MaslowCommunityGarden/The-Meticulous-Z-Axis/mainpicture.JPG

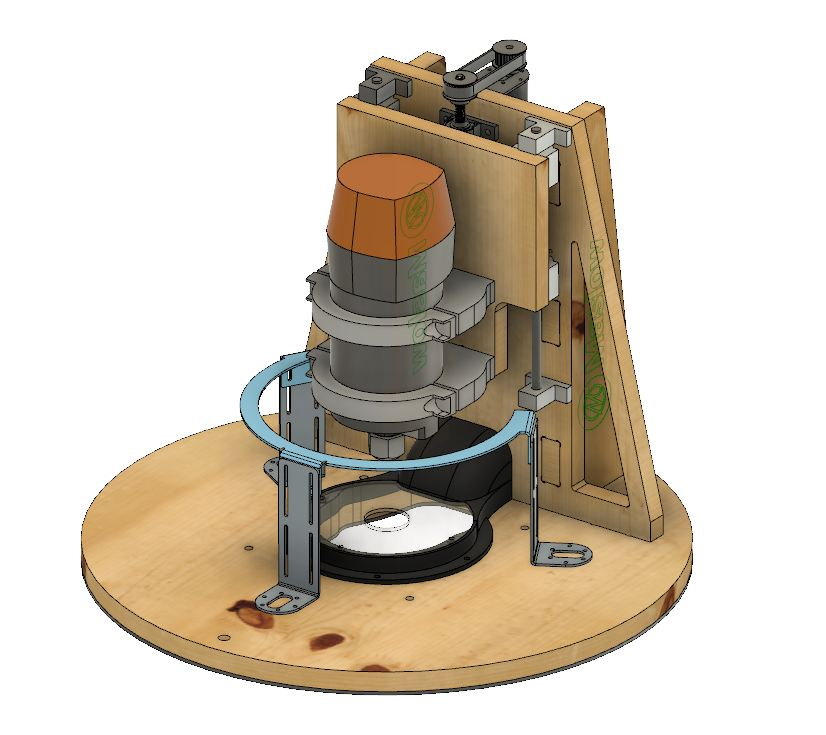
mainpicture.JPG
