MaslowCommunityGarden/The-Meticulous-Z-Axis/README.md

# The Meticulous Z-Axis

An improved Z-Axis sled that uses the Rigid R2200 as the spindle
