MaslowCommunityGarden/The-Meticulous-Z-Axis/2D CAD Files/MeticulousSled-Gussets.pdf

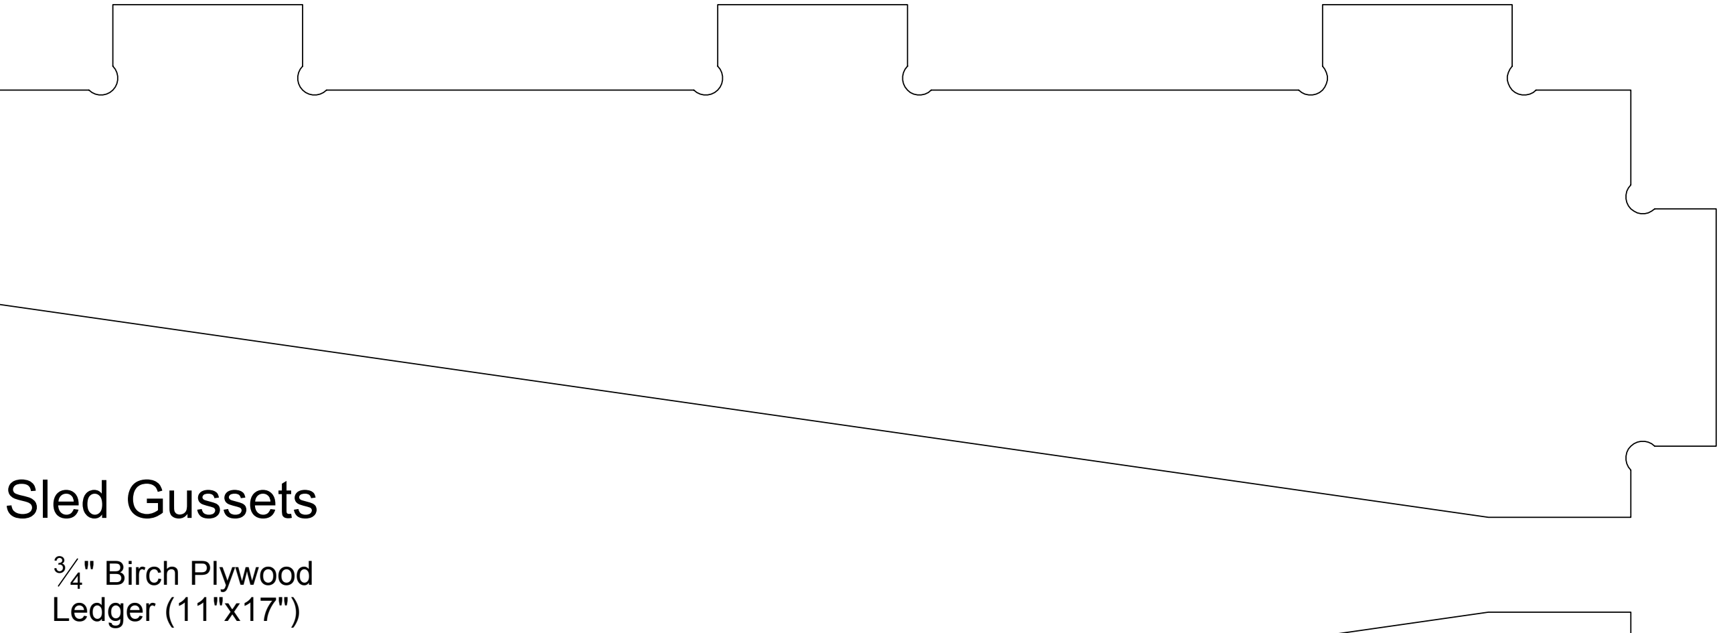
[picture p2: figure]
4" Birch Plywood Ledger (11"x17"); Sled Gussets
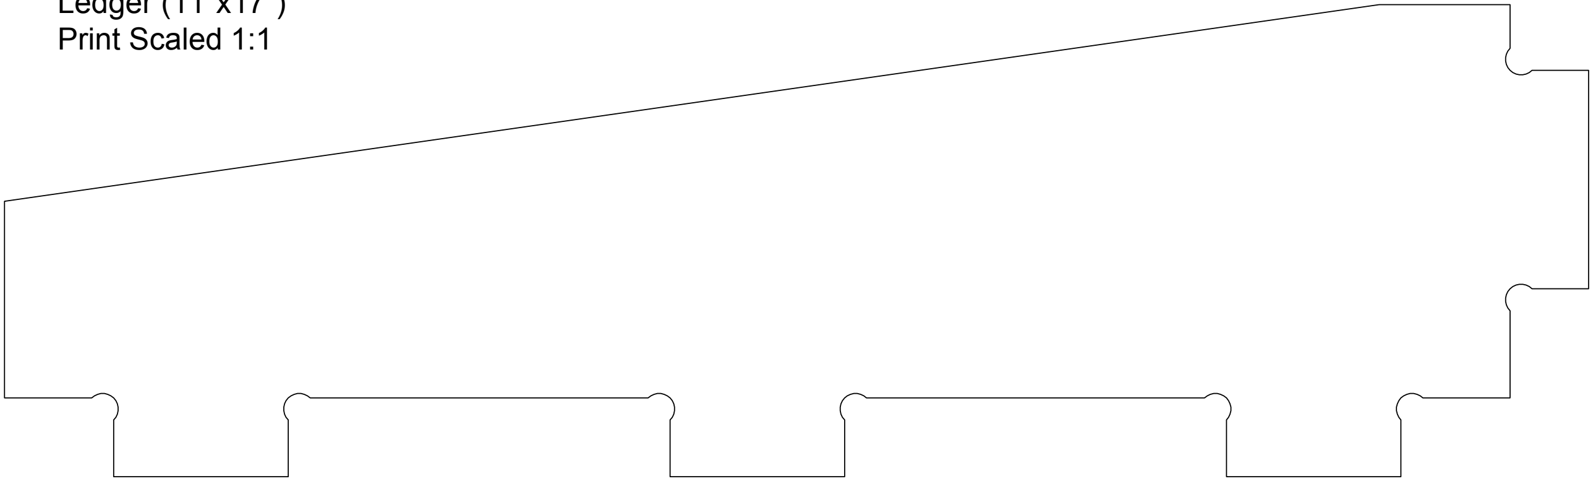
[picture p3: figure]
Print Scaled 1:1
