MaslowCommunityGarden/The-Meticulous-Z-Axis/2D CAD Files/MeticulousSled-PlywoodChuteWindow.pdf

1
8" Clear Acrylic
Letter (8.5" x 11")
Print Scaled 1:1

## Ply Chute Windows

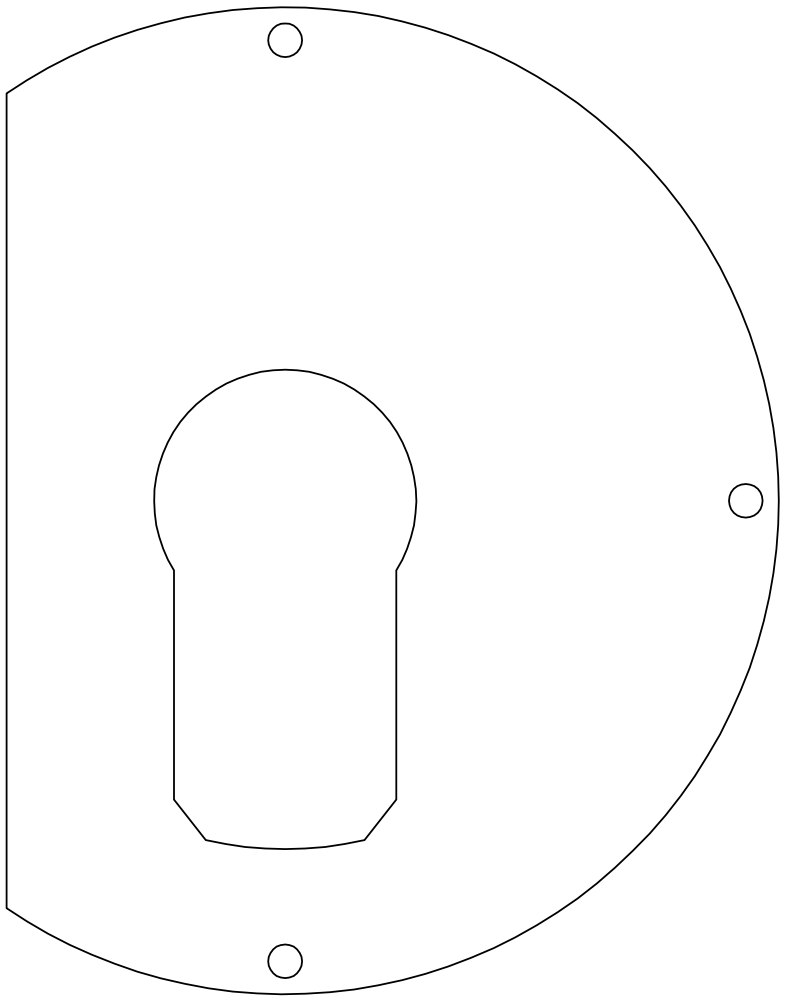
[picture p4: figure]
