MaslowCommunityGarden/The-Meticulous-Z-Axis/2D CAD Files/MeticulousSled-SpindleClamps.pdf

## Spindle Clamps

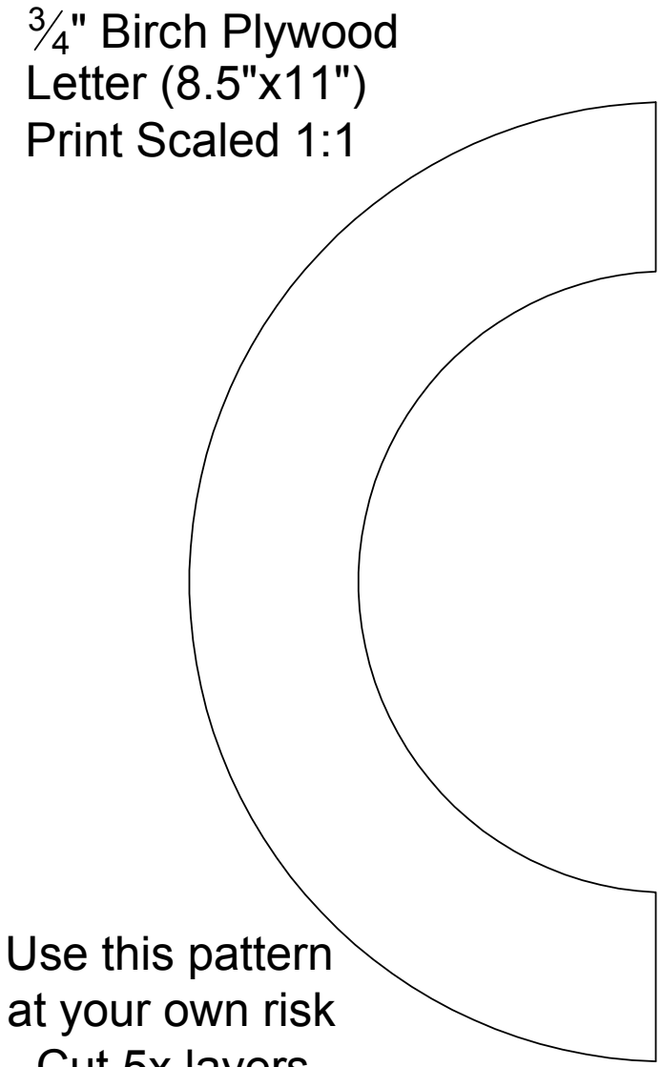
[picture p5: figure]
3 4" Birch Plywood Letter (8.5"x11") Print Scaled 1:1; Use this pattern at your own risk
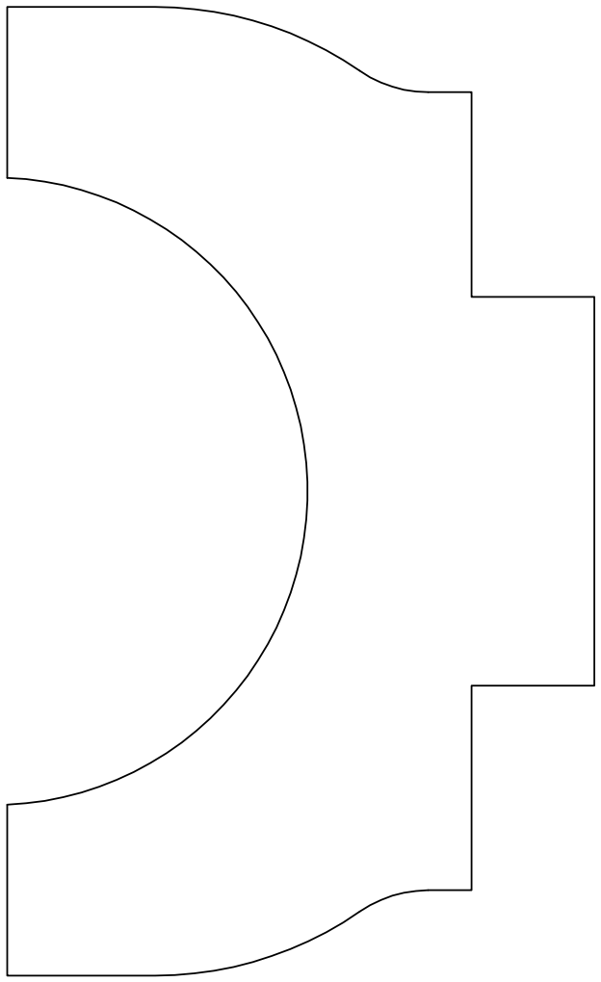
[picture p6: figure]
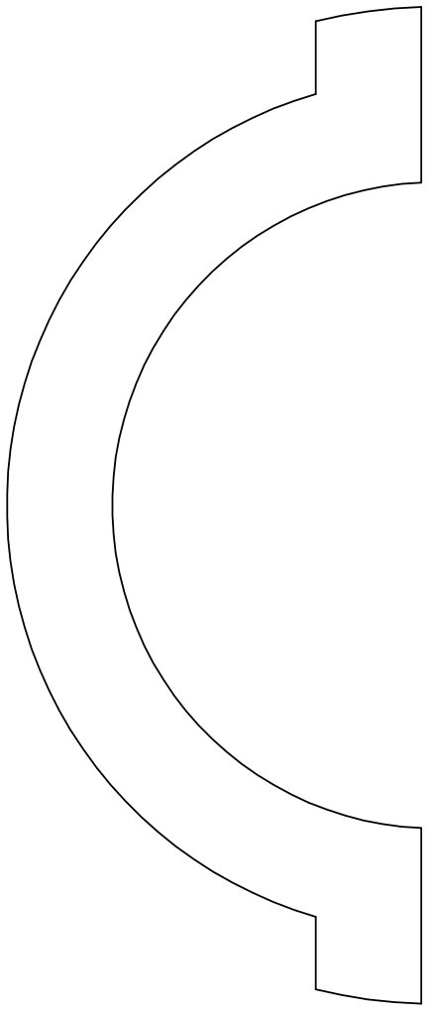
[picture p7: figure]

- Cut 5x layers
- Glue all layers
together
