MaslowCommunityGarden/The-Meticulous-Z-Axis/BOM.md

Z-Axis - $67.92 before shipping

* [300mm Linear rail and lead screw kit](https://www.amazon.com/Mergorun-Horizontal-Bearings-coordinate-equipment/dp/B06XP7HPLQ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) - Amazon - $35.99

* [XL 10 tooth Timing Pulley for lead screw](https://www.amazon.com/uxcell-Aluminum-Timing-Pulley-Flange/dp/B0747G2D4S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) - Amazon - $6.69

* [XL 30 tooth Timing Pulley for servo motor](https://www.amazon.com/dp/B00JR6MIJO/ref=twister_B07T5SDJJQ?_encoding=UTF8&th=1) - Amazon $9.75

* [XL 1/4" x 9" timing belt](https://www.amazon.com/gp/product/B00CMI70T2/ref=crt_ewc_title_huc_2?ie=UTF8&psc=1&smid=ATVPDKIKX0DER) - Amazon - $11.99

* [12x 10-32 Threaded inserts for softwood](https://www.amazon.com/Z-Threaded-Hex-Flush-Internal-Threads/dp/B002WC8TSY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) - Amazon - $3.50

* An assortment of #8 wood screws

* 2x 1/4-20 x 1 1/2" hex cap screws, with nylock nut and washers

* 12x 10-32 x 3/4" Pan Head Machine Screws

* [16x M4 x 0.7 x 30mm Pan Head Machine Screws](https://www.homedepot.com/p/Everbilt-M4-0-7-x-30-mm-Phillips-Pan-Head-Zinc-Plated-Machine-Screw-2-Pack-802908/204282670) - linked pack is 2x per pack, order 8x for needed quantity. 

Spindle Clamps:

* [8x 3/8"-16 Heat set threaded inserts](https://www.mcmaster.com/93365A310/)

* [4x 3/8"-16 x 3/4" Socket Cap screws](https://www.mcmaster.com/91251A622/)

* [4x 3/8"-16 x 3/4" Flat Head screws](https://www.mcmaster.com/90273A439/)

Dust Hood:

* [3x 10-32 Heat-set Insert](https://www.amazon.com/initeq-Threaded-Inserts-Printing-Plastic/dp/B07B9P9R3B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) - Amazon - $8.49

* 3x 10-32 x 5/16" Flat head Machine screws

* Some form of plastic glue or epoxy to help glue the chute and body of the hood together.
