MaslowCommunityGarden/The-Meticulous-Z-Axis/2D CAD Files/MeticulousSled-Plywood_Nested.dxf

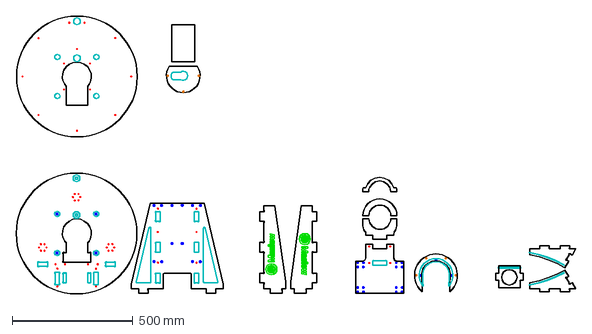
[picture p8: CAD file, 2019-10-13]
2D CAD Files/MeticulousSled-Plywood_Nested.dxf
2317.8 x 1150.1 mm
