MaslowCommunityGarden/The-Meticulous-Z-Axis/STL Files/Spindle Bracket Top Back.stl

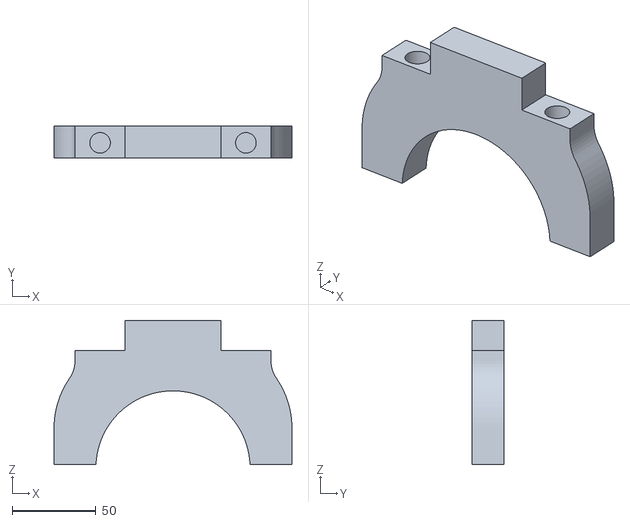
[picture p9: CAD file, 2020-06-02]
STL Files/Spindle Bracket Top Back.stl
142.0 x 19.0 x 86.0
