MaslowCommunityGarden/The-Meticulous-Z-Axis/2D CAD Files/MeticulousSled_Nested.dxf

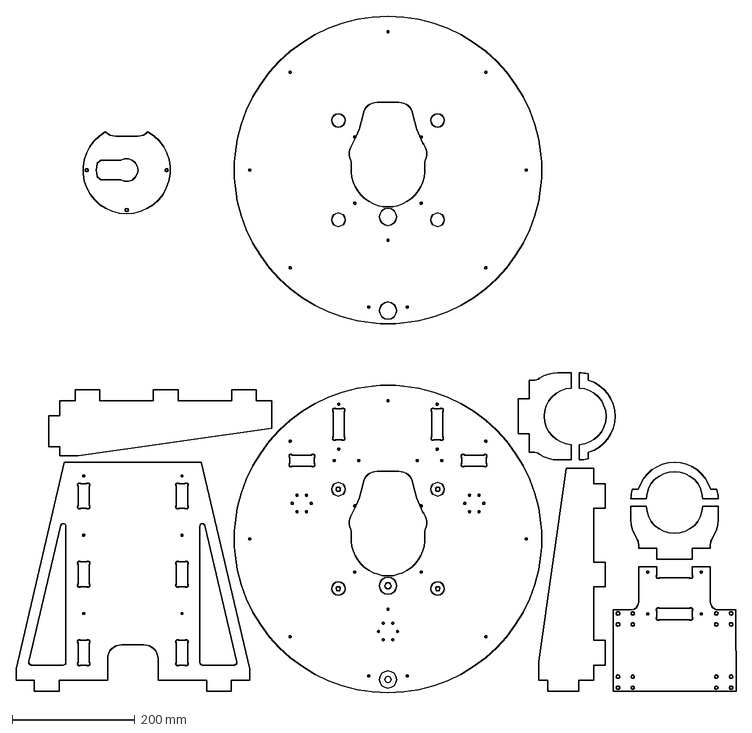
[picture p10: CAD file, 2019-08-20]
2D CAD Files/MeticulousSled_Nested.dxf
1171.0 x 1100.0 mm
