MaslowCommunityGarden/The-Meticulous-Z-Axis/STL Files/Spindle Bracket Top Front.stl

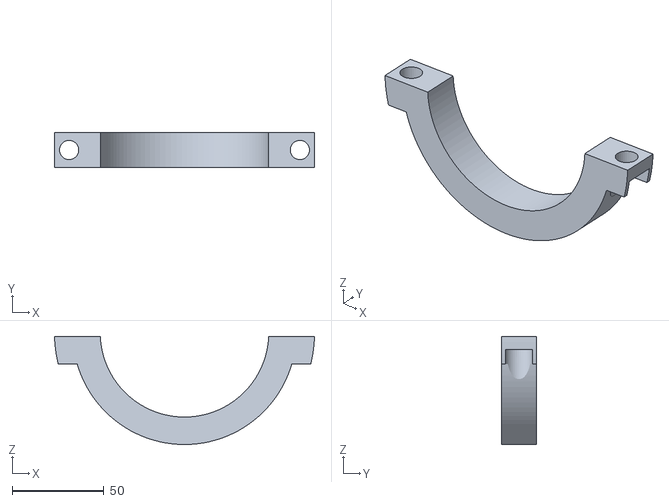
[picture p11: CAD file, 2020-06-02]
STL Files/Spindle Bracket Top Front.stl
141.9 x 19.0 x 59.0
