MaslowCommunityGarden/The-Meticulous-Z-Axis/STL Files/Dust Hood Chute V2.stl

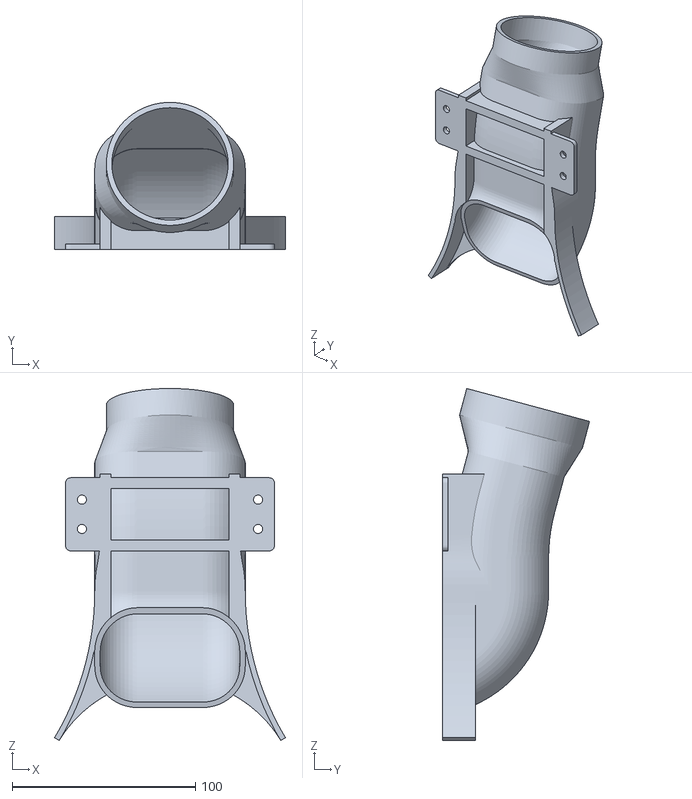
[picture p12: CAD file, 2018-07-31]
STL Files/Dust Hood Chute V2.stl
126.1 x 80.4 x 192.2
