MaslowCommunityGarden/The-Meticulous-Z-Axis/STL Files/Dust Hood Body V2.stl

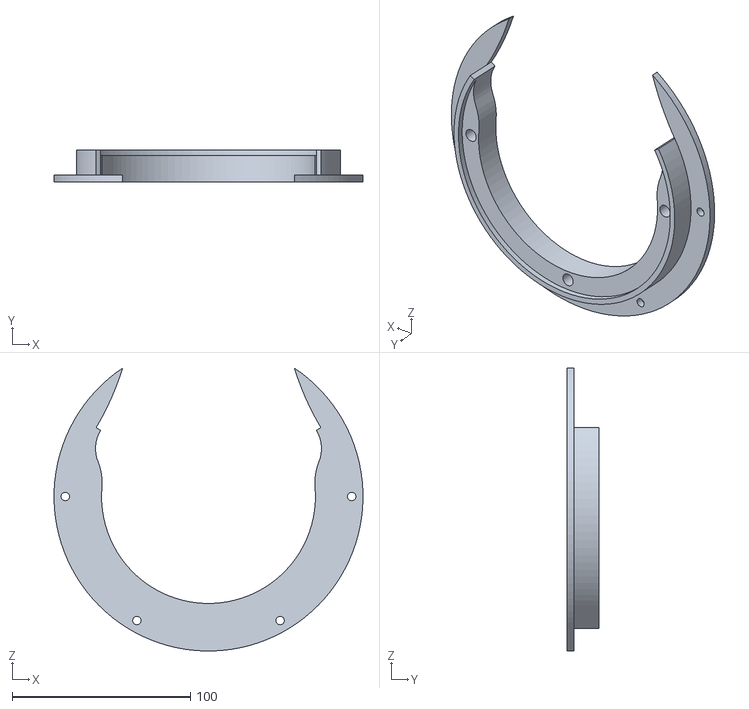
[picture p13: CAD file, 2018-07-31]
STL Files/Dust Hood Body V2.stl
173.4 x 18.0 x 158.8
