MaslowCommunityGarden/The-Meticulous-Z-Axis/STL Files/Z_Axis_Lead_Screw_Nut_Bracket.stl

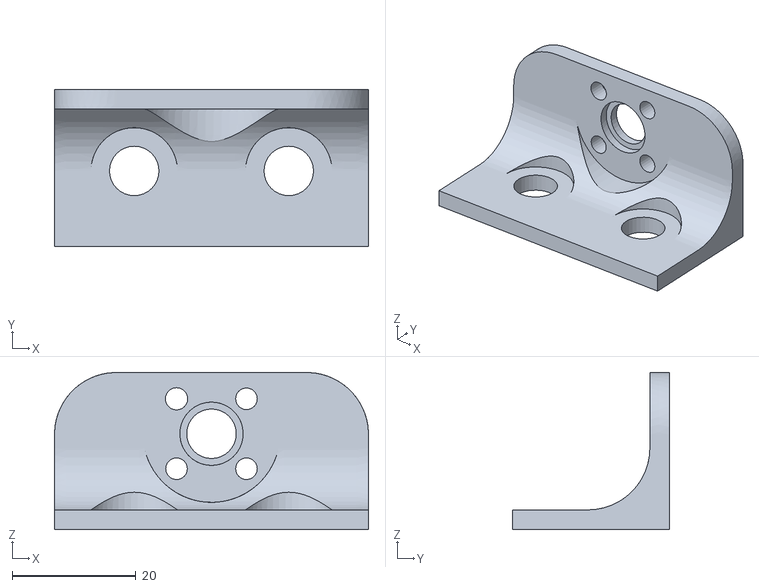
[picture p14: CAD file, 2020-06-02]
STL Files/Z_Axis_Lead_Screw_Nut_Bracket.stl
50.8 x 25.4 x 25.4
