MaslowCommunityGarden/The-Meticulous-Z-Axis/(list of files, cad)

Other CAD files:
2D CAD Files/MeticulousSled-Drawings.dwg
