MaslowCommunityGarden/The-Meticulous-Z-Axis/2D CAD Files/MeticulousSled-PrintedChutePad.pdf

## Printed Sled Pad

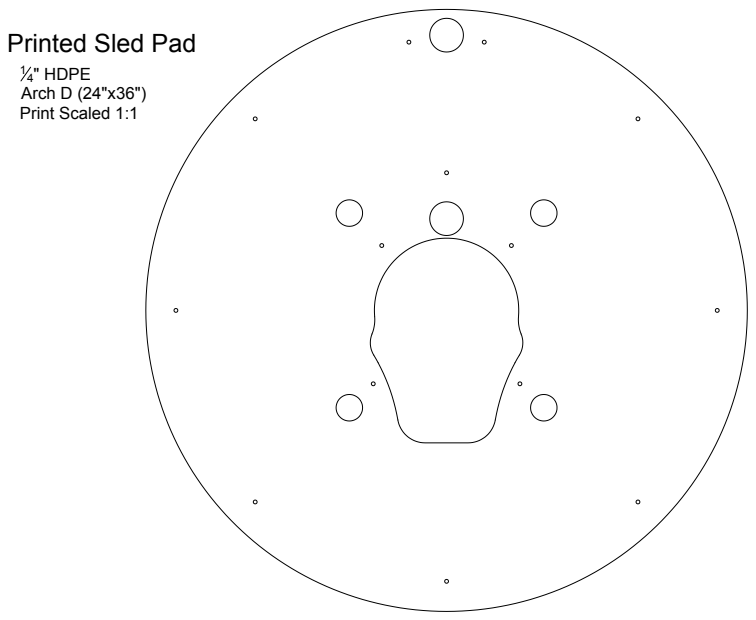
[picture p15: page 1]
4" HDPE Arch D (24"x36") Print Scaled 1:1
