MaslowCommunityGarden/The-Meticulous-Z-Axis/2D CAD Files/MeticulousSled-PrintedChuteTemplate.pdf

## Printed Sled Templates

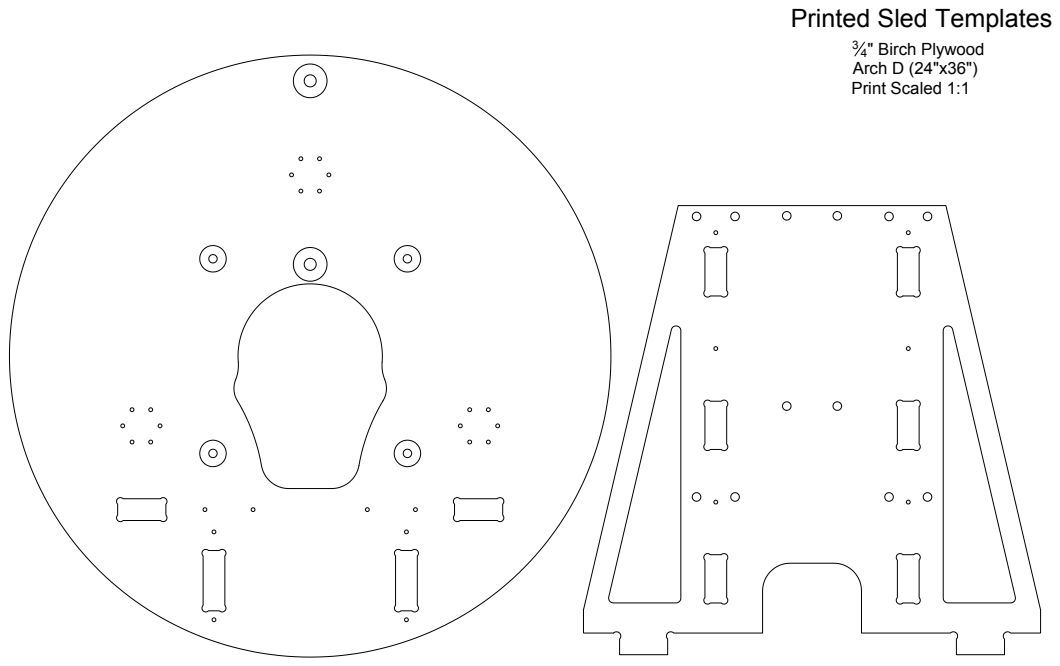
[picture p16: page 1]
4" Birch Plywood Arch D (24"x36") Print Scaled 1:1
