MaslowCommunityGarden/The-Meticulous-Z-Axis/2D CAD Files/MeticulousSled-Carriage.pdf

## Carriage Plate

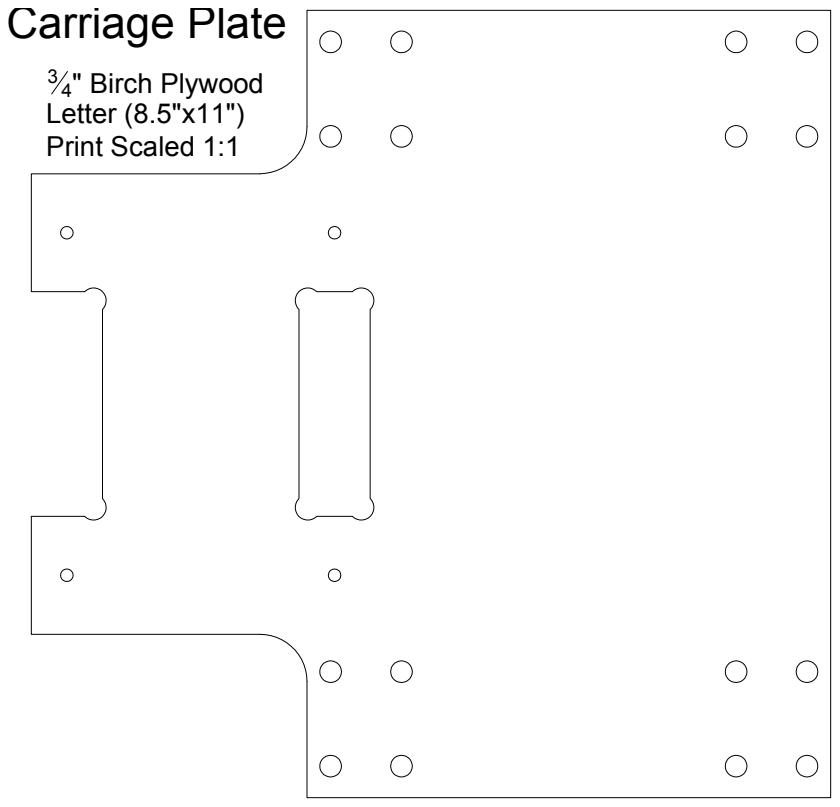
[picture p17: page 1]
4" Birch Plywood Letter (8.5"x11") Print Scaled 1:1
