MaslowCommunityGarden/The-Meticulous-Z-Axis/2D CAD Files/MeticulousSled-PlywoodChute.pdf

# Ply Chute

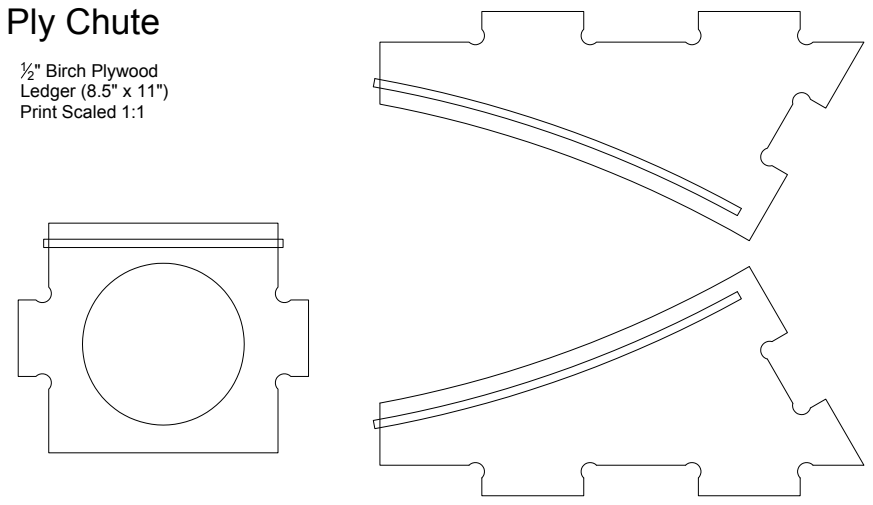
[picture p18: page 1]
2" Birch Plywood Ledger (8.5" x 11") Print Scaled 1:1
