MaslowCommunityGarden/The-Meticulous-Z-Axis/2D CAD Files/MeticulousSled-PlywoodChuteHorseshoe.pdf

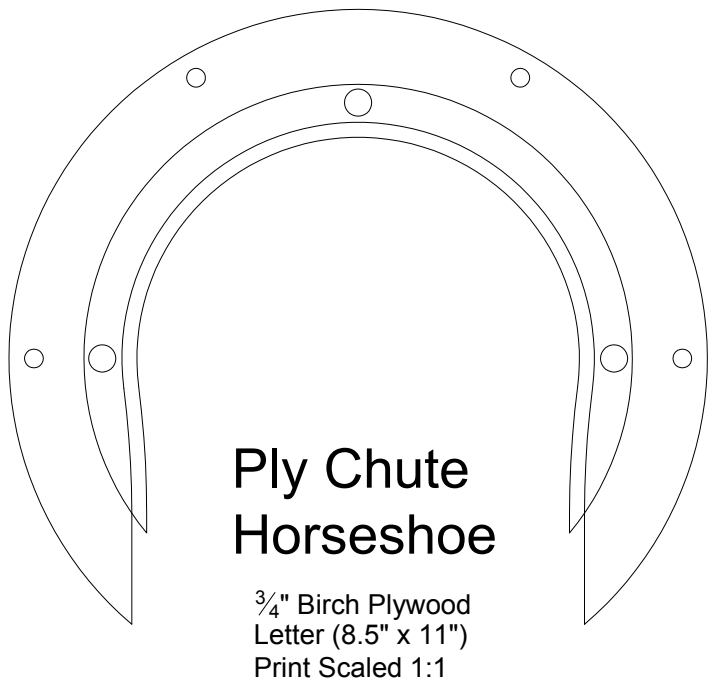
[picture p19: page 1]
3 4" Birch Plywood Letter (8.5" x 11") Print Scaled 1:1; Ply Chute Horseshoe
