MaslowCommunityGarden/The-Meticulous-Z-Axis/2D CAD Files/MeticulousSled-PlywoodChutePad.pdf

## Plywood Sled Pad

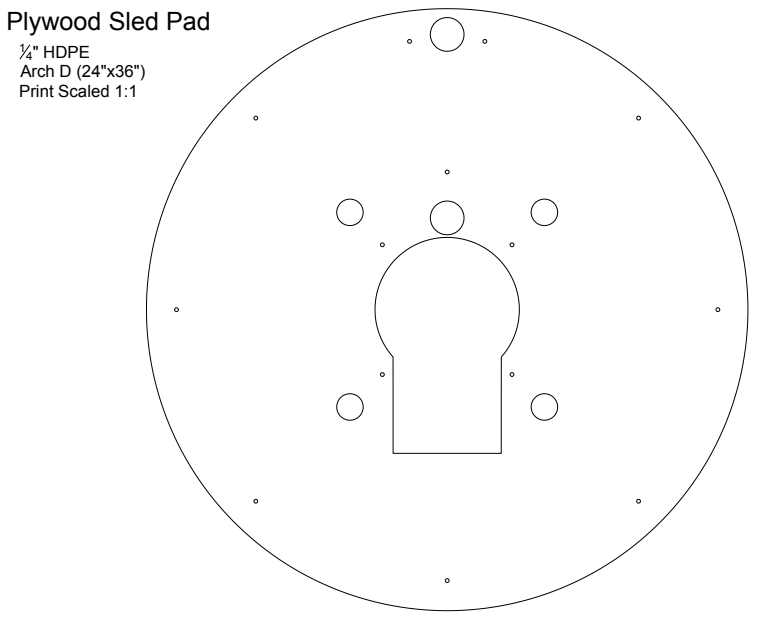
[picture p20: page 1]
4" HDPE Arch D (24"x36") Print Scaled 1:1
