MaslowCommunityGarden/The-Meticulous-Z-Axis/2D CAD Files/MeticulousSled-PlywoodChuteTemplate.pdf

## Plywood Sled Templates

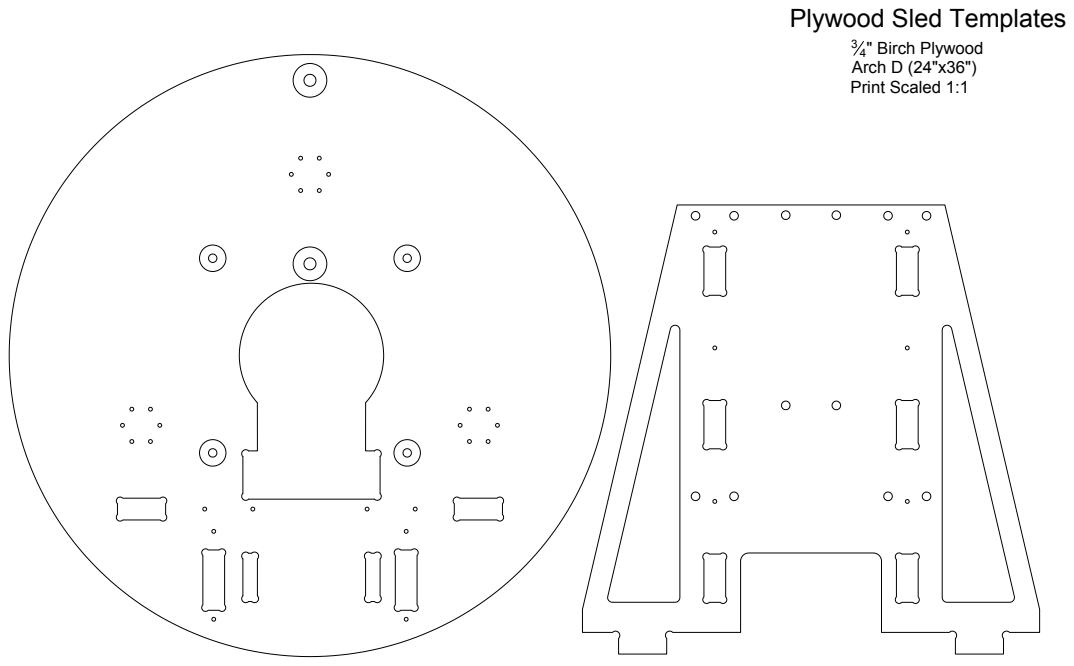
[picture p21: page 1]
4" Birch Plywood Arch D (24"x36") Print Scaled 1:1
