MaslowCommunityGarden/The-Meticulous-Z-Axis/2D CAD Files/MeticulousSled-PrintedChuteWindow.pdf

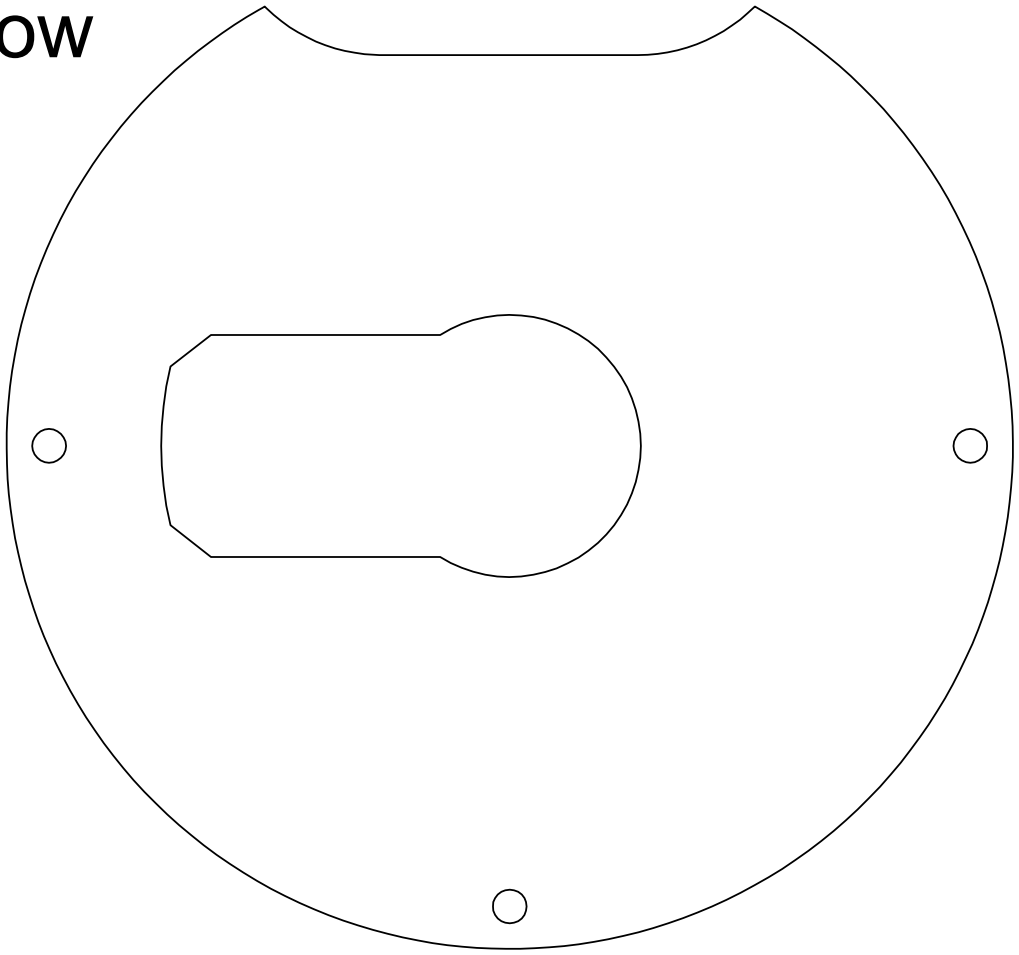
[picture p22: figure]

1
8" Clear Acrylic
Letter (8.5" x 11")
Print Scaled 1:1

## Printed Chute Window
