MaslowCommunityGarden/The-Meticulous-Z-Axis/(commit log)

2018-04-13 init commit
    [Dust Hood Body.stl, Dust Hood Chute.stl, Hose Adaptor 1250in.stl, Hose Adaptor 1500in.stl, Hose Adaptor 2250in.stl, Hose Adaptor 2500in.stl, Hose Adaptor 3000in.stl, Prototype Sled Nested.dxf]
2018-04-23 Update BOM.md
    I removed the press fit pulleys from McMaster in favor of set screw pulleys found on aliexpress and automation direct.
2018-04-23 Update BOM.md
    Got the gear ratios backwards... that was dumb of me.
2018-04-23 Update BOM.md
    grammar
2018-04-24 Update BOM.md
    Added an option for the lead screw/linear guide that doesn't ship from China.
2018-06-05 Convert ROBOT.md file to use json format
    Using the json format will make it easier for us to store meta data to categorize and tag projects. The garden is filling up (which is AMAZING!!) but its starting to get a little cluttered. I am hoping to introduce more organization soon and switching the ROBOT.MD files to use json is the first step.
2018-07-31 Cleaning House for New Files
    Cleaning House for New Files
    I'm deleting a bunch of the v1.0 parts to make way for the v2.0
    [Hose Adaptor 3000in.stl]
2018-07-31 Added V2 models to the stl folder
    V2 parts for the improved dust collector.
    [Dust Hood Body V2.stl, Dust Hood Chute V2.stl]
2018-09-08 New DXF files to match the new design.
    [Prototype Sled Nested V2.dxf]
2019-02-24 Updating nc files
    Added predrill holes for Bar's ring system mounting brackets.
2019-02-24 New Dust Chute nc files
    These ones have the new profile for the improved 3D printed dust chute.
2019-02-25 Adding NC files for the plywood dust chute
    I've finished up programming toolpaths for the Meticulous Z-axis plywood dust chute
2019-02-25 Adding 2D CAD files for the plywood dust chute
    See the layers of the file for materials, tooling, cut depth.
    [Plywood Dust Chute.dxf]
2019-03-08 Drilling template for sled
    A D sized template of the hole locations for the sled.
2019-04-02 Hardware added to BOM
    Adding in more hardware for the changes I've been working on for the revised assembly.
2019-07-18 New NC Files! :D
    New NC code for your Maslows. This is currently only the main version with the 3D printed parts. The fully Maslow-able version will follow.
    Deleted a whole ton of obsolete files.
2019-08-14 Adding cut files for fully Maslowable Sled
2019-08-20 Cleaning house
    Deleting an obsolete file
    [Prototype Sled Nested V2.dxf]
2019-08-20 Adding WIP DXf's
    These are basic, dimensionally accurate 2D CAD files. They are not layered for CAM, yet.
    [MeticulousSled-Plywood_Nested.dxf, MeticulousSled_Nested.dxf]
2019-09-11 Added instructions for calibrating the pitch
    This was requested on the forums, and was relatively easy to add.
2019-10-11 Updated the BOM
    Cleaned up a bunch of links in here, everything now ships easily within the US. Narrowed down all the pulleys to simplify everything
2019-10-11 Updated the timing belt
    The previous link I provided too waaaaaaay too long to ship.
2019-10-13 Cleaning house
    [MeticulousSled-Plywood_Nested.dxf]
2019-10-13 New 2D CAD Files
    Uploading DXF's of both versions of the sleds, as well as PDF templates of all the parts.
    [MeticulousSled-Drawings.dwg, MeticulousSled-Plywood_Nested.dxf, MeticulousSled_Nested.dxf]
2020-01-04 Added in the metric hardware for the bearing block
2020-05-27 I updated the lead screw pitch
    The new pitch is the correct one, I had an error in my previous math.
2020-06-02 Adding files
    I just realized the spindle clamp files weren't here
    [Spindle Bracket Top Back.stl, Spindle Bracket Top Front.stl]
2020-06-02 Forgot something else
    [Z_Axis_Lead_Screw_Nut_Bracket.stl]
2020-08-14 Hardware tweaks
    Fixing some quantities, adding in spindle clamp hardware
